evanpham/spin-to-win/README.md

# spin-to-win
4 half-bridge universal motor driver capable of driving brushed DC, BLDC, PMSM, switched reluctance, and stepper motors
