evanpham/spin-to-win/Notes/sw_architecting/bridge_driver_architecture.html

# Bridge Driver & SVM Orchestrator

SW Architecture detail · child document of Motor Driver Architecture · Revision 0.1

## Component Breakdown

svm_orchestrator

Coordinator

Responsibility

Receives a voltage vector command (V_alpha, V_beta) normalized to [-1, +1] from foc_u_guy. Determines the SVM sector, computes dwell times for the two active vectors and the zero vector, and derives per-phase duty cycles. Writes all three bridge_cmd_t structs atomically before any BridgeDriver consumes them.

Inputs

svm_cmd_t — V_alpha, V_beta (float, normalized), V_dc (for scaling)

Outputs

bridge_cmd_t[3] — duty cycle + enable for phases A, B, C. Written atomically via shadow register pattern before commit trigger.

Notes

Only instantiated for 3-phase motor types (BLDC, PMSM). Bypassed entirely for brushed DC (foc_u_guy writes directly to a single BridgeDriver) and stepper (separate orchestrator per winding pair). This is the sole component that has visibility across all three phases simultaneously — no other component should compute cross-phase duty relationships.

bridge_driver

Realtime · ×N instances

Responsibility

Owns one half-bridge. Accepts a bridge_cmd_t (duty, enable, brake). Applies dead time insertion. Writes high-side and low-side duty to PWM peripheral. Responds to gate kill signal from Fault_Responder by immediately disabling both outputs regardless of pending commands.

Inputs

bridge_cmd_t — duty (float 0–1), enable (bool), brake (bool)
gate_kill (software) — secondary flag checked each cycle before PWM write
LTC7066 EN pin — primary hardware gate kill, owned by fault_responder/watchdog GPIO, independent of this SWC

Outputs

PWM signals to LTC7066 HIN and LIN pins. No software output — purely a hardware actuator.

What it does NOT know

It has no knowledge of which phase it is, what motor topology is in use, or what any other bridge_driver instance is doing. All cross-phase coordination is the orchestrator's responsibility.

## Signal Flow

From control loop

foc_u_guy
V_alpha, V_beta

→

svm_orchestrator
sector + dwell times

↓ bridge_cmd_t[A,B,C] — atomic commit

Per-phase actuation

bridge_driver[A]
dead time · PWM

·

bridge_driver[B]
dead time · PWM

·

bridge_driver[C]
dead time · PWM

↓ HIN / LIN

Hardware

LTC7066 ×3
gate drivers

→

FET half-bridges ×3
motor phases

Atomic commit requirement: svm_orchestrator must write all three bridge_cmd_t structs and then issue a single commit before any BridgeDriver reads. If BridgeDriver[A] sees a new duty while B and C still hold old values, a spurious voltage vector is applied for one PWM cycle. Implementation: shadow register pattern — orchestrator writes to pending structs, single commit flag triggers all three reads simultaneously. Whether LEDC/RMT supports hardware-level sync across channels needs to be verified (see TODO below).

## Data Structures & Interfaces

Struct

Producer → Consumer

Notes

svm_cmd_t

V_alpha, V_beta, V_dc

foc_u_guy → svm_orchestrator

Same-task write, no sync needed. Normalized floats. V_dc passed for modulation index calculation.

bridge_cmd_t

duty [0–1], enable, brake

svm_orchestrator → bridge_driver ×3

Shadow register pattern. Orchestrator writes all three, then sets commit flag. BridgeDrivers latch on commit. For brushed DC: foc_u_guy writes directly to one bridge_driver, bypassing orchestrator.

LTC7066 EN GPIO

active-low hardware pin

fault_responder / watchdog → LTC7066 EN pin (hardware)

Primary gate kill path. fault_responder and control_loop_watchdog own a GPIO wired to all LTC7066 EN pins (or per-bridge independently). Pulling EN low disables both gate outputs immediately at hardware speed — independent of Core 1 firmware state. All four EN pins may share one GPIO for simultaneous kill, or be independent for phase-selective shutdown. Single GPIO is simpler and sufficient for most fault responses.

gate_kill (software)

atomic bool

fault_responder → bridge_driver (software, belt-and-suspenders)

Checked by bridge_driver at top of each PWM write cycle. Secondary path only — the hardware EN GPIO is the authoritative gate kill. Software gate_kill provides graceful shutdown for non-emergency cases where the control loop is still running.

## Reuse Across Motor Topologies

Motor Type | Orchestrator | bridge_driver instances | Notes
BLDC / PMSM | svm_orchestrator | 3 (phases A, B, C) | Full SVM sector switching. All instances coordinated.
Brushed DC | none — direct | 1 (H-bridge = 2 half-bridges, or just 1) | foc_u_guy writes duty directly to bridge_driver. Simple PI on current. svm_orchestrator not instantiated.
Stepper | stepper_orchestrator (TBD) | 2 (winding A, winding B) | Separate orchestrator handles microstepping phase relationships. bridge_driver reused unchanged.
Switched reluctance | sr_sequencer (TBD) | up to 4 | Unipolar switching per phase. Simpler than SVM but requires rotor position gating. bridge_driver reused.

## Open TODOs

TODO — LEDC/RMT atomic multi-channel update Verify whether ESP32 LEDC or RMT peripherals support synchronised duty updates across multiple channels (i.e. all three phase duties latching on the same PWM carrier reload event). If not natively supported, shadow register pattern must be implemented in software with a commit flag polled at the top of each BridgeDriver update. Research: ESP-IDF LEDC docs, LEDC timer sync / LEDC_LSTIMER_RST, RMT simultaneous channel start.

TODO — Dead time value Dead time inserted by bridge_driver between high-side off and low-side on (and vice versa). Value must be selected based on FET gate charge / drive current from LTC7066 and FET datasheet turn-on/turn-off times. To be determined once MOSFETs are selected.

TODO — LEDC vs RMT selection LEDC sufficient for BLDC/PMSM/brushed DC. RMT offers more flexible waveform control needed for switched reluctance and stepper. Decision deferred to gate driver test board phase. bridge_driver abstraction should hide this choice — the PWM peripheral write is an internal implementation detail.
