evanpham/spin-to-win/Notes/circuit_design/Circuit notes.docx

Open source ESP32 dev board which can be a great starting point for the ESP32 side of things

- https://oshwlab.com/lckfb-team/lcsc-esp32s3r8n8-dev-board
- Can dev out just the motor control side of things on a separate board and breadboard them together. ESP32 on-board ADC sucks so we wont have any analog signals from ESP32 to driver board.

I/O check:

- 4x half bridge drivers – 8x PWM (assuming TTL/CMOS and not 3-state PWM)
- ADC channels (in rough order of importance)
  - 4x phase current sense
  - 4x phase voltage sense
  - Battery+ voltage sense
  - Chassis voltage sense (if doing floated chassis ground wrt battery)
  - This all seems like it generally fits on a single SPI ADC (https://www.analog.com/en/parametricsearch/2418) with decent sampling rate
  - 4x more current and voltage sense channels with different gains (for different current and/or voltage ranges)
    - Add another SPI ADC here optionally
- Encoders
  - Say 2x SPI hall encoders as a worst case scenario (1 for motor shaft and another for some geared down output shaft position or something)
- Onboard MPU/IMU (for funsies)
  - Call it 1x I2C interface, though it could also use other protocols I think. The rate req here isn’t too high I think
- Temp sensors
  - Could maybe fold this into the ADC channels if we make a constant current source, but should also be able to get away with putting external temp sensors on I2C. Absolute worst case its 8x more I2C devices

Total:

  - 3x SPI devices (maybe 5x for large voltage/current dynamic range and an extra encoder interface)
    - This is problematic for the ESP32 which has 2 SPI interfaces. Need to use chip select or drop items
    - Can start try building the PCB with everything and seeing if we can adequately load manage the SPI interfaces with chip select. Need to start thinking about control rate requirements
    - MISO, MOSI, CLK for each interface, CS for each device means 7 pins for all SPI devices
  - 1-9x I2C device
    - In theory this should be doable on a single bus, bus capacitance might become an issue
    - 2 pins for all I2C devices
  - 8x PWM channels (1 pin each)
  - UART for programming
    - Already consumed on dev board
  - 17 GPIO pins needed – 28 available (2x restricted in style of use) – WE GUCCI I THINK
