evanpham/spin-to-win/Notes/circuit_design/Gate drivers.docx

Gate drivers

- General note: for switched reluctance motors where you only want a quarter bridge per phase, we may need to use the low side of each half bridge since the top side fet of gate drivers often relies on a bootstrap cap to drive the gate above the power rail. The bootstrap cap wont charge if we never drive the low side fet
- DRV8301 (https://www.ti.com/lit/ds/symlink/drv8301.pdf?ts=1771530802075) and similar 3 phase drivers don’t necessarily scale up to 4 bridge boards without wasted space. Individual bridge drivers will be more flexible I think
- Analog devices
  - There are motor drivers with lots of integrated features (https://www.analog.com/en/parametricsearch/3995)
    - TMC4671 (https://www.analog.com/en/products/TMC4671.html) does the whole control shebang. FOC (not sensorless tho) with 4 half-bridge PWM interfaces. Needs external gate drivers tho
      - This is mostly cheating. I want to make something like this to learn from. Excluding this option because it’s a cheat code
    - TMC6100 and similar (https://www.analog.com/en/products/TMC6100.html) great for 3-phase. Charge pump allows 100% duty cycle if we want high-side control for SRM
    - Lots of stepper specific options but they mostly seem to not allow independent high+low side control. Most of them hide control internally offering only step/direction or serial interfaces
  - LTC7068 (https://www.analog.com/en/products/LTC7068.html) and similar look simple, but are missing some features like built-in overcurrent protection and DC conversion (need external power stage to give ~12V to driver)
    - No independent top+bottom gate control. No good for 3-phase system
  - LT8418 (https://www.analog.com/en/products/LT8418.html) kinda nice with it. Can take 3.85-5.5V input so we could power it with the same 5V supply we use for the ESP32
    - No shoot-through protection tho
  - ADUM series (https://www.analog.com/en/products/ADUM3223.html) generally not rated for the output voltages we are looking for, but highlight gate command/gate drive output isolation which is potentially useful in preventing issues where phase voltage couples to driver logic voltage through the bootstrap cap. Keep an eye out for this feature on other boards or issues related to this kind of Ferencerence
  - MAX series (https://www.analog.com/en/products/MAX15018.html) solid but not shoot through protections and ~12V Vdd req. Probably strictly better to use the LT8418 unless we have a ~12V rail for something else
  - LTC706x series (https://www.analog.com/en/resources/analog-dialogue/articles/floating-ground-non-isolated-half-bridge-gate-drivers.html) seems like it has almost everything we need
    - Shoot through protection
    - High output voltage capability (100V and up)
    - Fancy shmancy isolated ground ref between gate drive outputs… allegedly helpful for noise immunity. Not sure we need this but maybe helpful to have the option to keep the output ground ref separate from the logic power. This may be required to implement a chassis float between Vatt+ and -
    - There are 3-state pwm and TTL/CMOS input versions
      - 3-state requires an PWM signal to step between high, medium, low, to control the FETs, while the TTL/CMOS lets us control the FETs independently with 2x digital signals per FET. Trade between I/O density vs I/O complexity. Leaning TTL/CMOS on a gut check
    - Generally caaaan take ~5V but its at the very low end of the range. May end up with a logic power rail a bit higher than 5V if we want to use the same rail for both gate driver power and the 3v3 LDO. Or could implement a ~12V rail for this chip
- TI chips
  - https://www.ti.com/product-category/power-management/gate-drivers/half-bridge/overview.html
  - LMG1205 (https://www.ti.com/lit/ds/symlink/lmg1205.pdf?ts=1771463339534) can take 5V logic but has no shoot through protection
  - LM5113 (https://www.ti.com/product/LM5113-Q1) also takes 5V logic but no shoot through protection
  - TI calls shoot through protection “input interlock”
  - Nothing that has shoot through protection seems to take 5V logic power. General question then, would I rather implement shoot through protection or a ~12V power rail?
    - Neither seems that hard honestly, but a 12V rail could come in handy down the line anyway (maybe in sense amp circuits or some other peripherals I want to add)
    - If I am going with a 12V rail, I’d rather go with the LTC706x series from Analog Devices since I like the possibility of having the input and output grounds separate here. Leaves me more room to play with different grounding schemes

I think the winner is the LTC7066 (https://www.analog.com/en/products/ltc7066.html)!

- Single half-bridge driver – easily scalable to 3-phase or 4-phase systems for a variety of motor types
- Shoot through protection
- Independent hi/lo gate control
- Isolated grounds between input/logic power and the output/bridge ground references
- Overkill output voltage rating (140V)
- Likely will require a ~12V rail
