evanpham/spin-to-win/Notes/sw_architecting/ADC timing and PWM sync.docx

PWM synchronization:

Are all PWM outputs from the ESP32 driven by the same PWM carrier? Or are the carriers for the ESP32 PWM outputs at least in phase? this phase alignment would be necessary to ensure the pwm triggering the adc conversion lines up with the pwm carrier valley (or peak, i think you could use either for settled current measurements. for high duty cycles switching would occur closer to the valley and for low duty cycles switching would occur closer to the peak assuming center aligned PWM right?)

ADC timing:

This forum post suggests that we cannot avoid the ISR latency for the DMA trigger

https://esp32.com/viewtopic.php?t=27809

I cannot find other sources to confirm or deny this claim. The post also mentions about 20us overhead in the ISR->DMA->xQueueSendFromISR->task switch flow which would be significant at my ~20kHz rate though not insurmountable. This may require some experimentation and we may end up needing to run the control loop from within an ISR like we mentioned before.

Although, is DMA actually useful here given the data acquisition and control loop are the only things running on core 1 and they must happen sequentially? control needs to wait for a new sample so im not sure there is any utility in offloading the transfer process to DMA while CPU just waits. Are there possibly speed advantages of having the data acquisition run directly in the main control loop instead of on a DMA+interrupt that triggers the main control loop?

Helpful and I think relevant links to ESP32 GPSPI documentation:

- Transaction duration: https://docs.espressif.com/projects/esp-idf/en/v6.0/esp32/api-reference/peripherals/spi_master.html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,Transaction%20Duration,%EF%83%81,-Transaction%20duration%20includes
  - CPU transactions ~2us quicker than DMA but limited to 64 bytes. This is enough for our whole burst (16 channels * 2 bytes = 32 bytes)
  - Polling transactions quicker than interrupt transactions. No specific transaction length is provided for the 8us transaction duration they provide but it must be no more than the allowable 64 byte polling transaction limit. We can probably consider 8us + conversion+acquisition time to be our max delay between conversion trigger and data-in-memory-ready-for-use. Per page 37 of the AD7617 datasheet, the conversion+acquisition time for 8 channel pairs would be (tCONV + 25 ns) + (7)(tACQ + tCONV) ~= (545ns)+(7000ns)=7.545us. This means w should be able to get all 16 samples from a single ADC in approximately 16us, which is a notable but not catastrophic portion of our ~50us control loop period
  - Page 37 of the AD7617 data sheet confirms that busy stays high for the duration of the conversion sequence and we can wait for all channels to be converted before running a bulk SPI transaction
- For max sclk speed we need to use IO MUX pins (i believe these are VSPI and HSPI defaults on ESP32): https://docs.espressif.com/projects/esp-idf/en/v6.0/esp32/api-reference/peripherals/spi_master.html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
- Bus acquiring: https://docs.espressif.com/projects/esp-idf/en/v6.0/esp32/api-reference/peripherals/spi_master.html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
  - I dont understand exactly what this is doing, it seems like you reserve a bus so no other processes can use it and this helps reduce transaction time. We will have only one task running the ADC SPI bus so I think we can just acquire the bus once and never release it?
