evanpham/spin-to-win/Notes/circuit_design/System sizing.xlsx

Calcs for super basic hand-wavey requirements for the ESC. High level goal is this should be able to support a single motor driving an E-bike. Really just looking for initial target numbers so we know that we can do interesting things with the ESC
Human mass | 100 | kg
Vehicle mass | 15 | kg | mountain bike (high end of weight range)
Battery specific energy | 150 | Wh/kg | Common and achievable (https://www.researchgate.net/figure/Specific-power-vs-specific-energy-of-Li-Ion-batteries-distinguished-by-cell-chemistry_fig2_269297116)
Battery capacity | 1000 | Wh | Kinda a WAG. 10-20Ah seems typical for 36V and 48V E-bike batteries, so this would be on the high end
Battery mass | 6.666666667 | kg
Total mass | 121.6666667 | kg | Note: doesn’t include motor or drive electronics. Have some fudge factor so far and we can come back to include motor mass later if designing a real vehicle
Uphill
Incline | 20 | deg
Speed | 10 | km/h
 | 2.777777778 | m/s
Motor efficiency | 75% | See below* | not really including gear box efficiency here. These numbers are mostly WAGs anyway just design with margin
Min battery voltage | 36 | V
Wheel diameter | 0.75 | m | ~29" bike tire
Power req | 1511.919045 | W | minimum req to move mass up hill
Current req | 41.99775124 | A | minimum req to move mass up hill
The speed vs torque trade off can be handled later with motor Kv specs and gear box sizing
Force req | 408.2181421 | N | minimum req to beat gravity and hold speed
Gear ratio | 1 |  | input turns vs output turns
Torque req | 306.1636065 | Nm | minimum req to beat gravity and hold speed
Speed req | 3.703703704 | rad/s
 | 35.36776513 | rpm
* efficiency notes for PMSM
typically higher than 75% though this study only looked at 2 and 4 Nm loads (https://www.researchgate.net/publication/311761219_Impact_of_PWM_Control_Frequency_onto_Efficiency_of_a_1_kW_Permanent_Magnet_Synchronous_Motor_PMSM)
