evanpham/spin-to-win/Notes/circuit_design/Quantization error calc.xlsx

bits | steps | % range quantization error | ppm quantization error
8 | 256 | 0.195312% | 1953.125
9 | 512 | 0.097656% | 976.5625
10 | 1024 | 0.048828% | 488.28125
11 | 2048 | 0.024414% | 244.140625
12 | 4096 | 0.012207% | 122.0703125
13 | 8192 | 0.006104% | 61.03515625
14 | 16384 | 0.003052% | 30.51757812
15 | 32768 | 0.001526% | 15.25878906
16 | 65536 | 0.000763% | 7.629394531
17 | 131072 | 0.000381% | 3.814697266
18 | 262144 | 0.000191% | 1.907348633
19 | 524288 | 0.000095% | 0.9536743164
20 | 1048576 | 0.000048% | 0.4768371582
21 | 2097152 | 0.000024% | 0.2384185791
22 | 4194304 | 0.000012% | 0.1192092896
23 | 8388608 | 0.000006% | 0.05960464478
24 | 16777216 | 0.000003% | 0.02980232239
