evanpham/spin-to-win/Schematics/ADC_testboard/ADC_testboard.kicad_pcb

## KiCad design ShuttleRun_Game/ShuttleRun_Game.kicad_sch

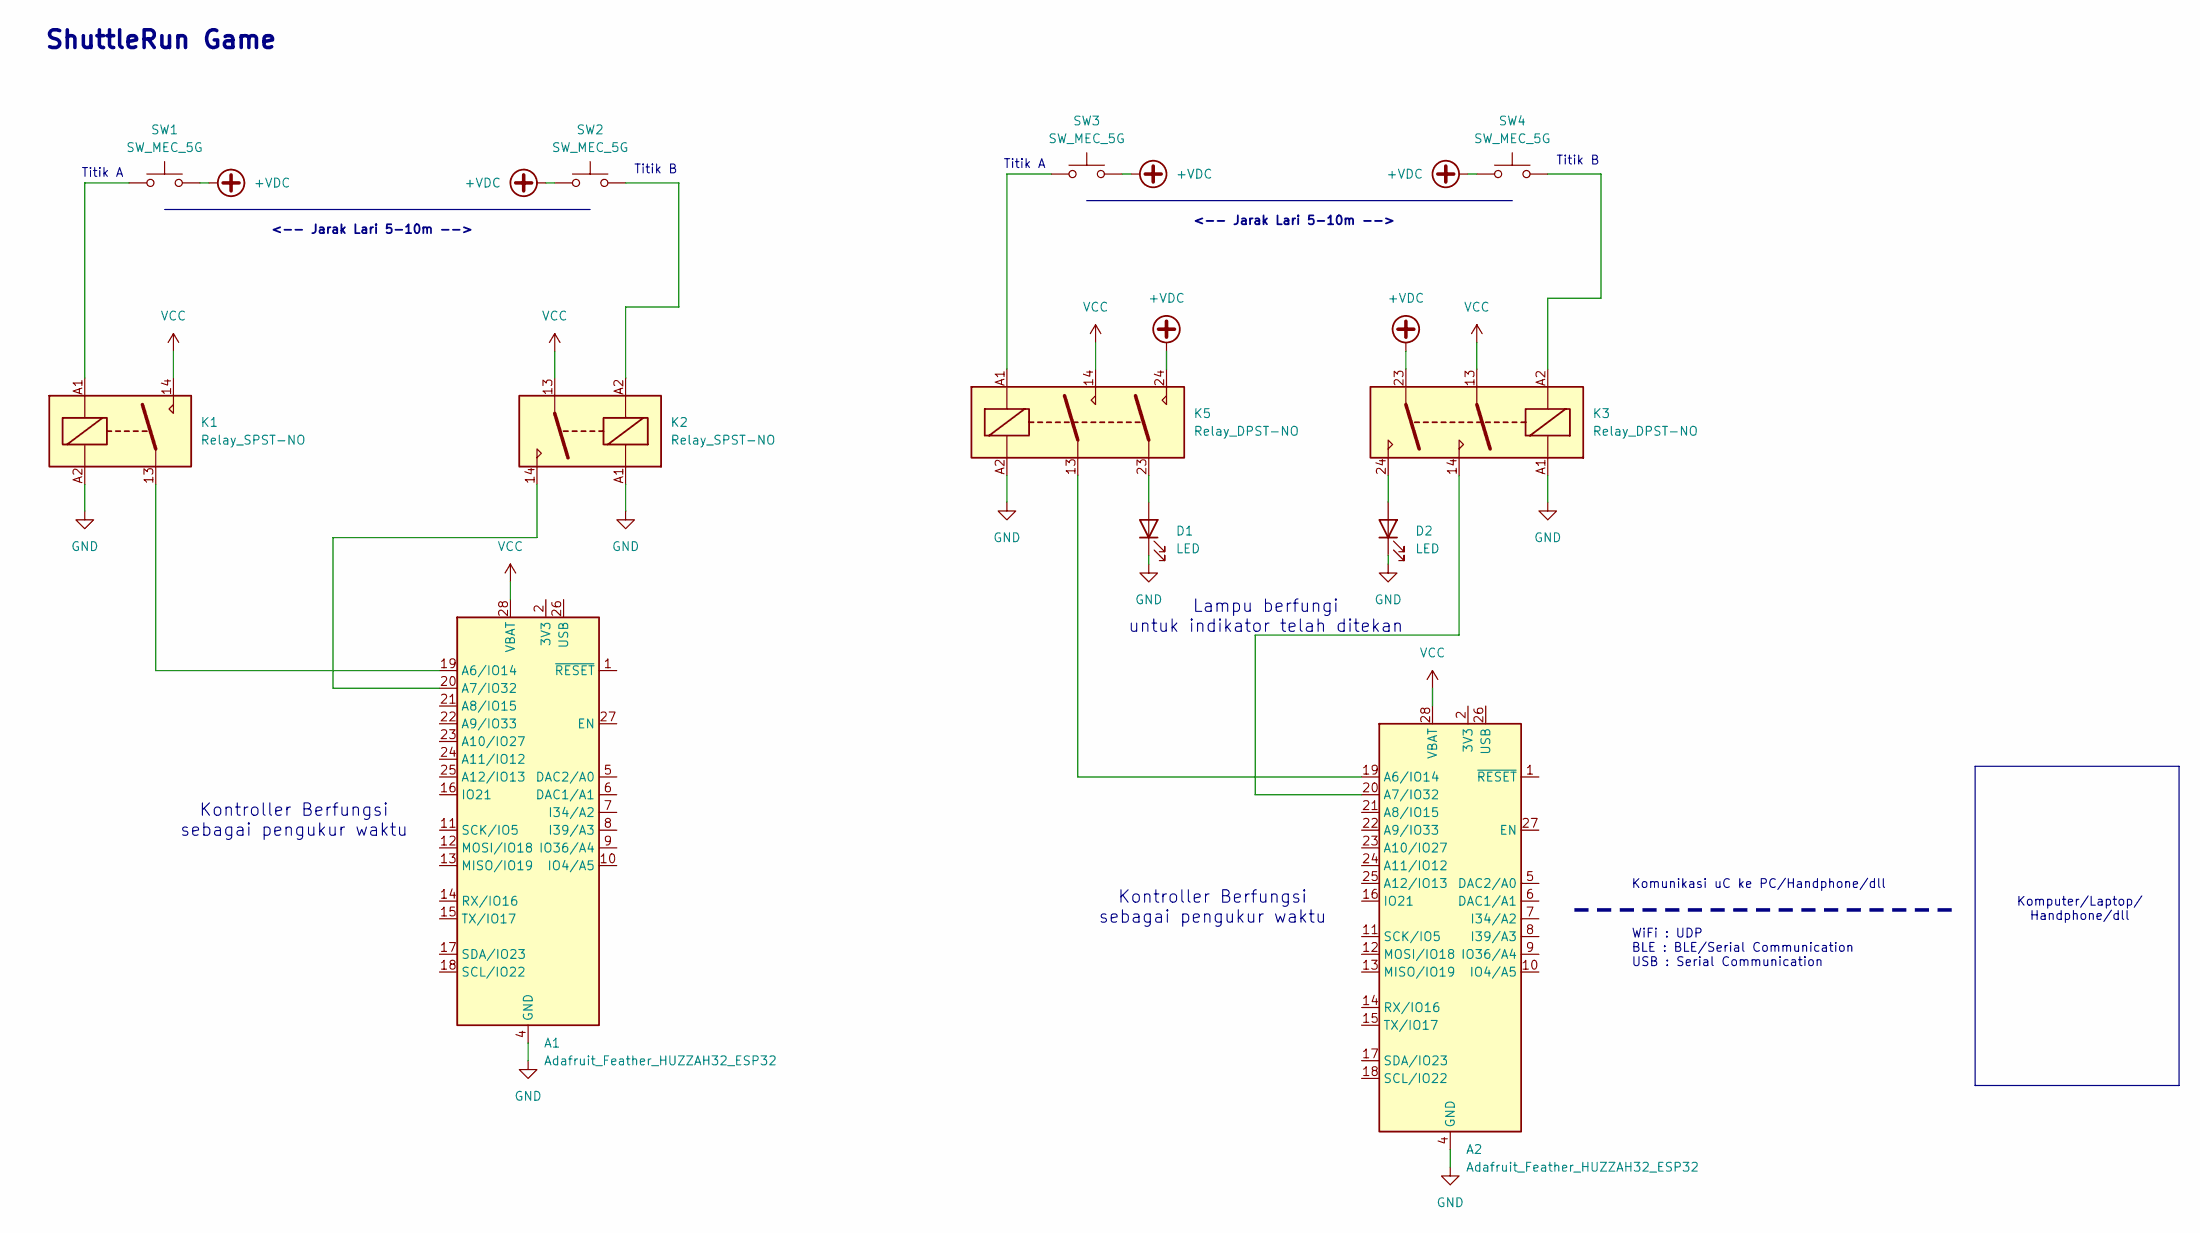
[picture p12: schematic ShuttleRun_Game.kicad_sch]

Parts:
A1, A2: Adafruit_Feather_HUZZAH32_ESP32; Adafruit_Feather
D1, D2: LED
K1, K2: Relay_SPST-NO
K3, K5: Relay_DPST-NO
SW1, SW2, SW3, SW4: SW_MEC_5G

Connections:
+VDC: K3.23, K5.24, SW1.3 (B), SW1.4 (B), SW2.1 (A), SW2.2 (A), SW3.3 (B), SW3.4 (B), SW4.1 (A), SW4.2 (A)
GND: A1.4 (GND), A2.4 (GND), D1.1 (K), D2.1 (K), K1.A2, K2.A1, K3.A1, K5.A2
unnamed: A1.19 (A6/IO14), K1.13
unnamed: A1.20 (A7/IO32), K2.14
unnamed: A2.19 (A6/IO14), K5.13
unnamed: A2.20 (A7/IO32), K3.14
unnamed: D1.2 (A), K5.23
unnamed: D2.2 (A), K3.24
unnamed: K1.A1, SW1.1 (A), SW1.2 (A)
unnamed: K2.A2, SW2.3 (B), SW2.4 (B)
unnamed: K3.A2, SW4.3 (B), SW4.4 (B)
unnamed: K5.A1, SW3.1 (A), SW3.2 (A)
VCC: A1.28 (VBAT), A2.28 (VBAT), K1.14, K2.13, K3.13, K5.14

Notes on the sheet:
ShuttleRun Game
Titik B
Titik A
<-- Jarak Lari 5-10m -->
Kontroller Berfungsi sebagai pengukur waktu
Komunikasi uC ke PC/Handphone/dll
Komputer/Laptop/ Handphone/dll
WiFi : UDP BLE : BLE/Serial Communication USB : Serial Communication
Lampu berfungi untuk indikator telah ditekan
