evanpham/spin-to-win/(commit log)

2026-03-15 creating schematics directory
    [ADC_testboard.kicad_pcb, ADC_testboard.kicad_sch]
2026-04-04 svm planning, motor sim header, sw architecting docs
    [Quantization error calc.xlsx, System sizing.xlsx, adc copy.kicad_sch, adc.kicad_sch]
